james10952001/Heathkit-ID-1590-adapter/proto.jpg

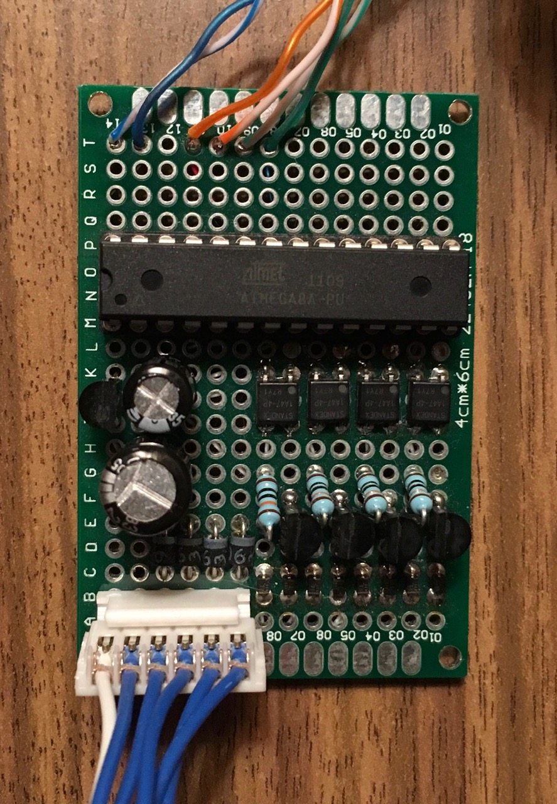
proto.jpg
