james10952001/Heathkit-ID-1590-adapter/ID-1590.jpg

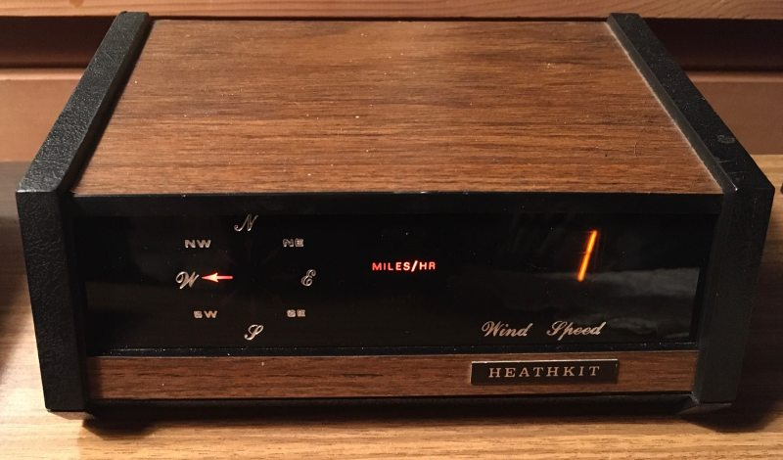
ID-1590.jpg
