james10952001/Heathkit-ID-1590-adapter/schematic.pdf

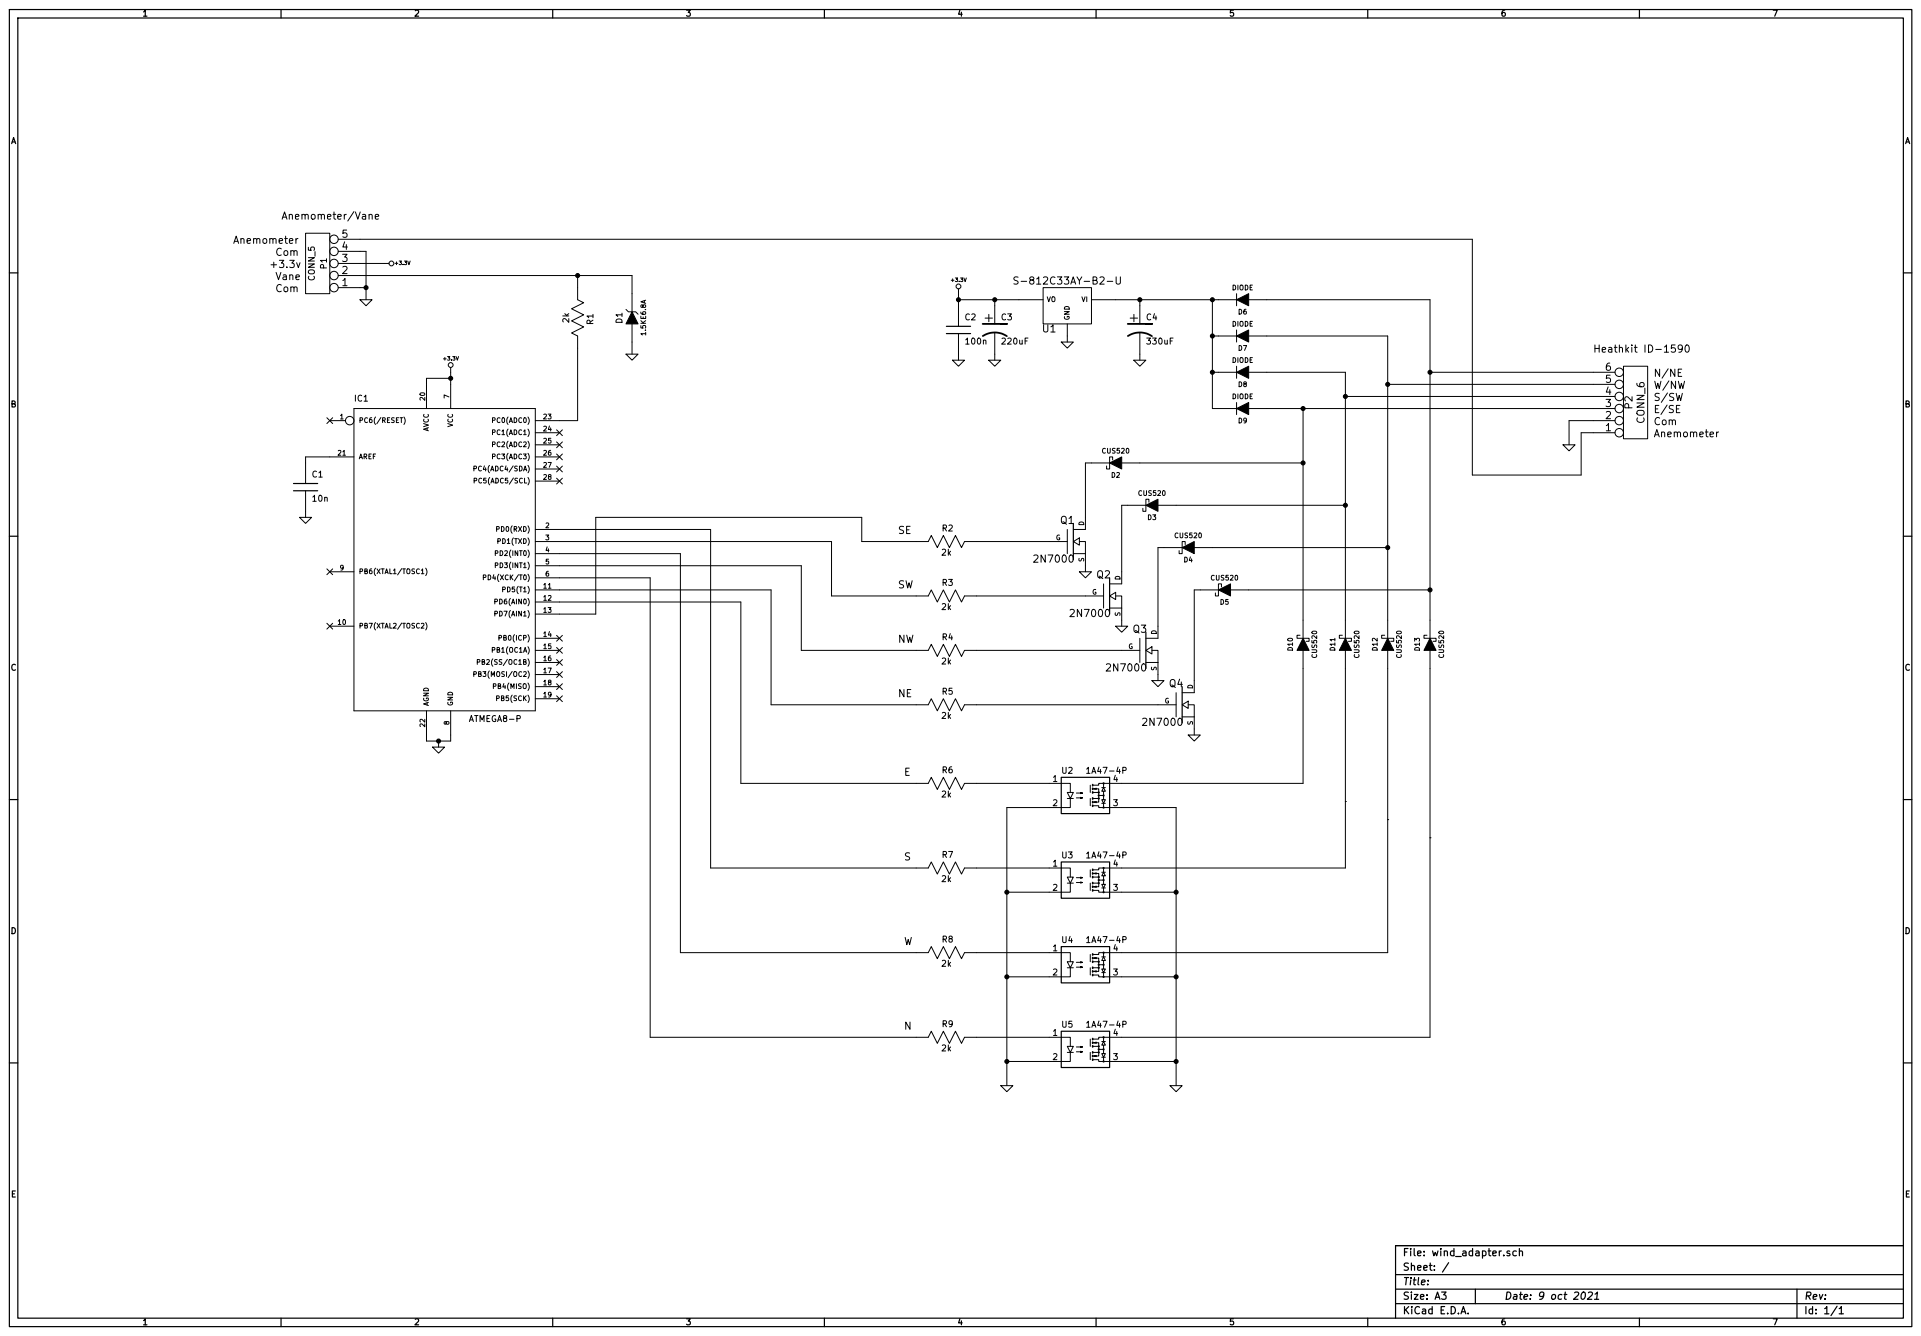
[picture p3: page 1]

Heathkit ID-1590 Anemometer/Vane Anemometer Com

8 PB6(XTAL1/TOSC1) 9 PB7(XTAL2/TOSC2) 10 AVCC 20 PD5(T1) 11 AREF 21 PD6(AIN0) 12 AGND 22 PD7(AIN1) 13 PC0(ADC0) 23 PB0(ICP) 14 PC1(ADC1) 24 PB1(OC1A) 15 PC2(ADC2) 25 PB2(SS/OC1B) 16 PC3(ADC3) 26 PB3(MOSI/OC2) 17 PC4(ADC4/SDA) 27 PB4(MISO) 18 PC5(ADC5/SCL) 28 PB5(SCK) 19

Id: 1/1 Title: File: wind_adapter.sch
Sheet: /
