james10952001/Heathkit-ID-1590-adapter/(commit log)

2021-10-09 Add files via upload
    Initial release of schematic and source.
2021-10-09 Update HeathWind.c
    Cleaned up some formatting that github mangled. It was nice and tidy in AVR Studio.
